unkyulee/bc250/images/001.jpeg

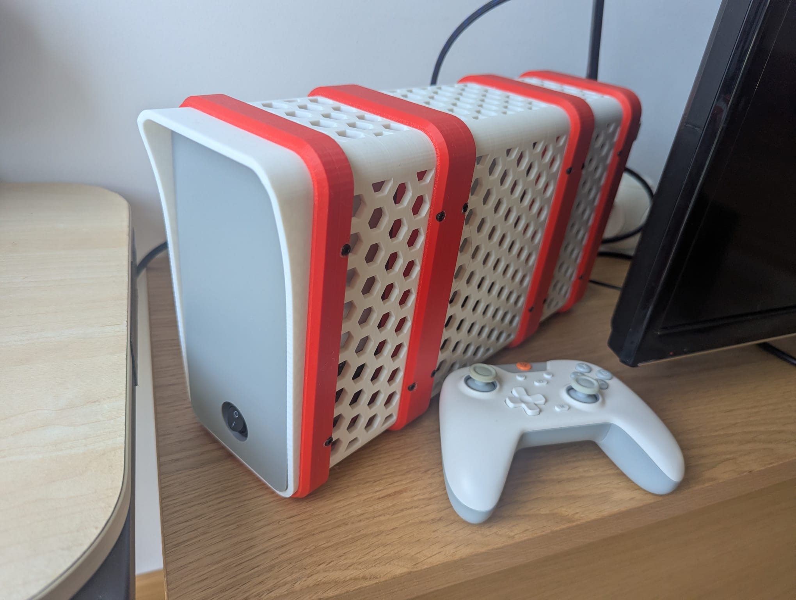
images/001.jpeg
