unkyulee/bc250/images/006.png

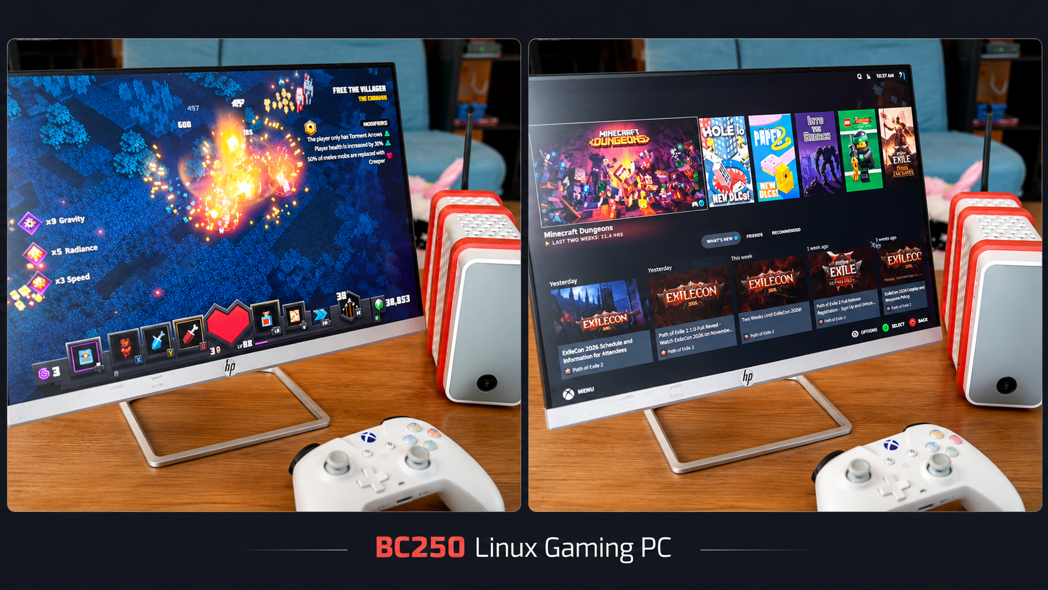
images/006.png
