unkyulee/bc250/STL/Fan Wall Front.stl

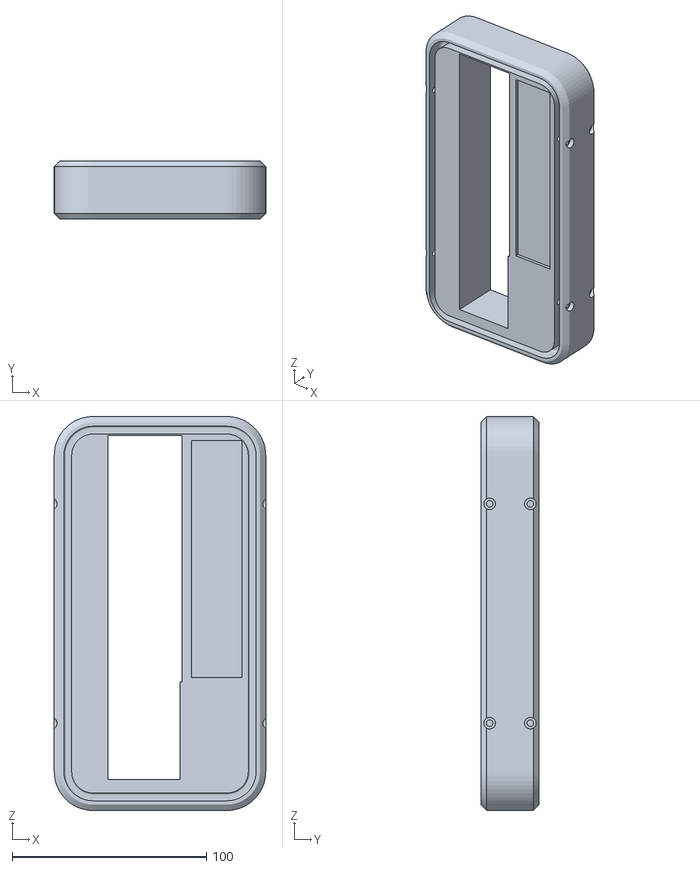
[picture p7: CAD file, 2026-10-29]
STL/Fan Wall Front.stl
109.0 x 30.0 x 203.0
