unkyulee/bc250/STL/Fan Wall Back.stl

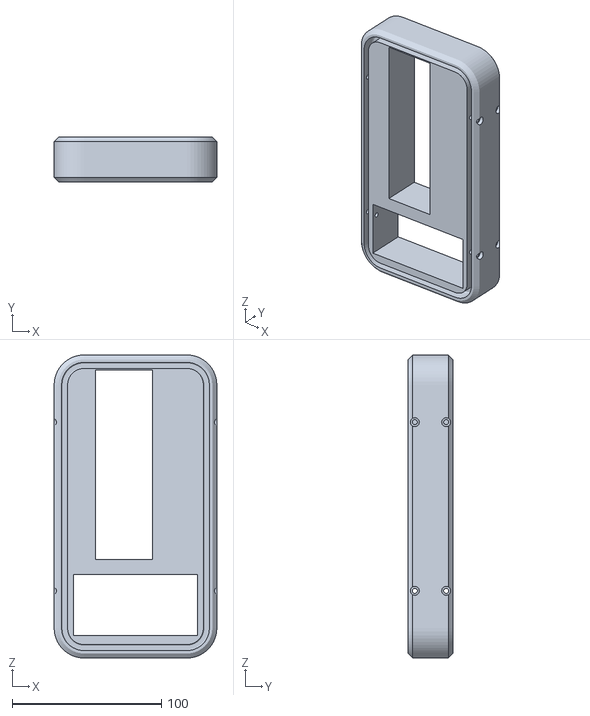
[picture p8: CAD file, 2026-10-29]
STL/Fan Wall Back.stl
109.0 x 30.0 x 203.0
