unkyulee/bc250/STL/p1s.3mf

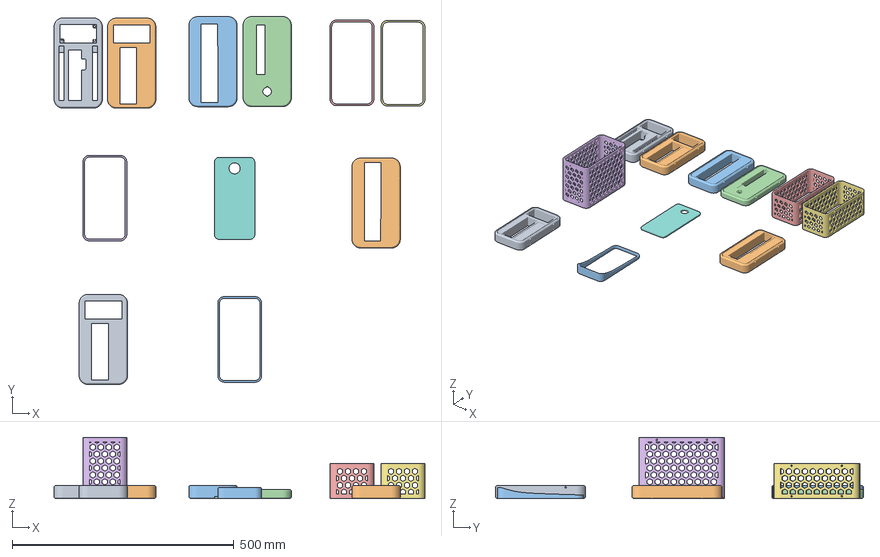
[picture p9: CAD file, 2026-10-29]
STL/p1s.3mf
835.3 x 828.9 x 138.0 mm
Back Face.stl
Fan Wall Back.stl x 2
Fan Wall Front.stl x 2
Front Face.stl
Cover Back.stl
Cover Fan.stl
Cover Front.stl
Front Panel.stl
Front Hood.stl
