unkyulee/bc250/STL/Back Face.stl

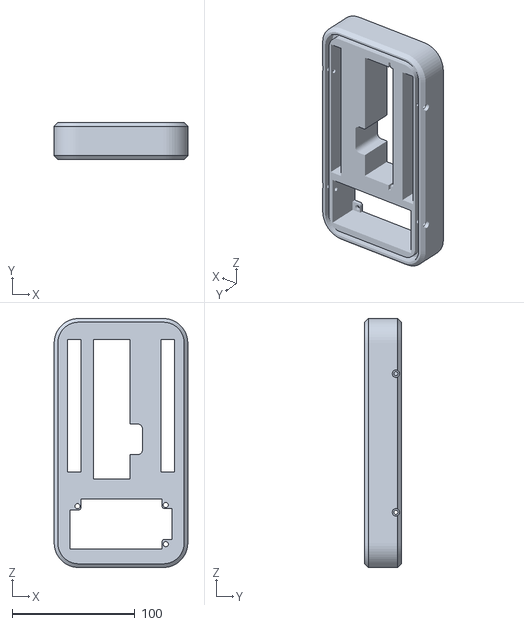
[picture p10: CAD file, 2026-09-11]
STL/Back Face.stl
109.0 x 30.0 x 203.0
