unkyulee/bc250/STL/Front Hood.stl

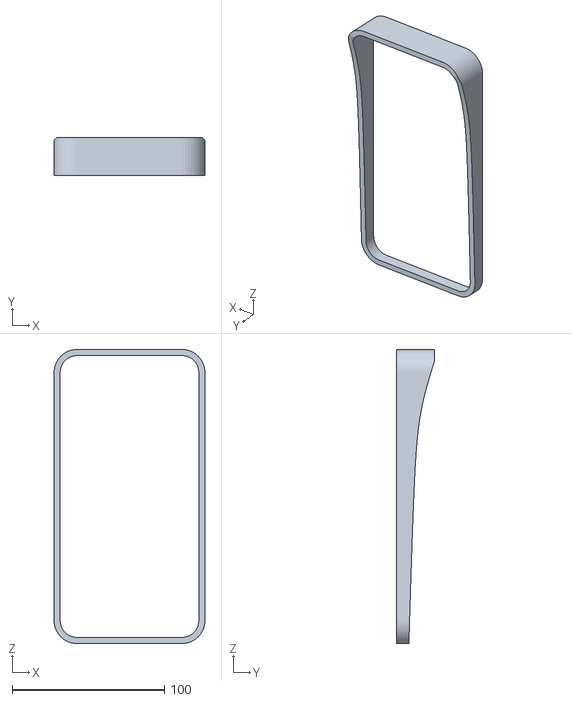
[picture p11: CAD file, 2026-09-11]
STL/Front Hood.stl
99.0 x 25.0 x 193.0
