unkyulee/bc250/STL/Cover Fan.stl

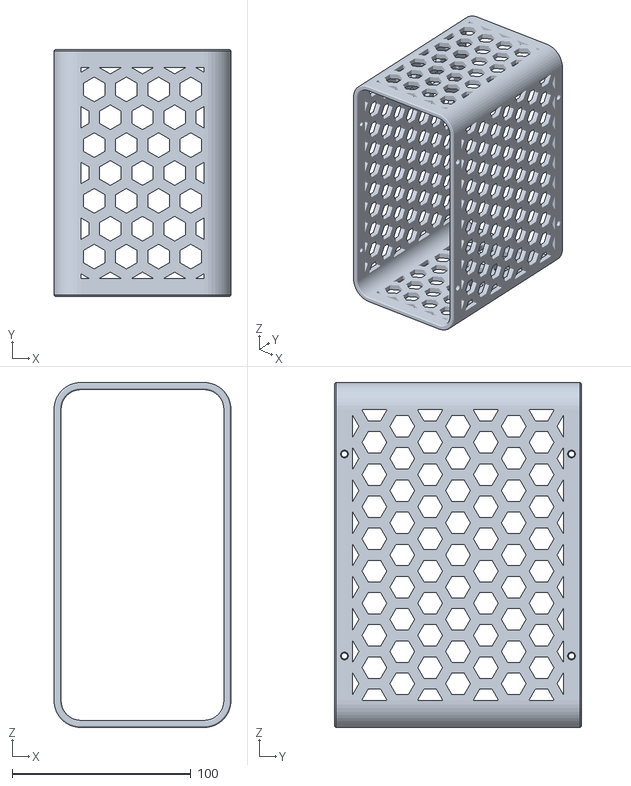
[picture p12: CAD file, 2026-09-11]
STL/Cover Fan.stl
99.0 x 138.0 x 193.0
