unkyulee/bc250/STL/Front Panel.stl

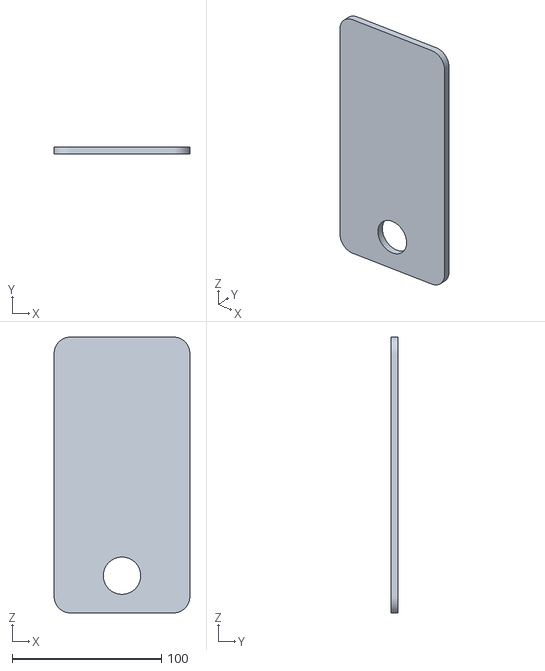
[picture p13: CAD file, 2026-09-11]
STL/Front Panel.stl
91.0 x 5.00 x 185.0
