unkyulee/bc250/STL/Cover Back.stl

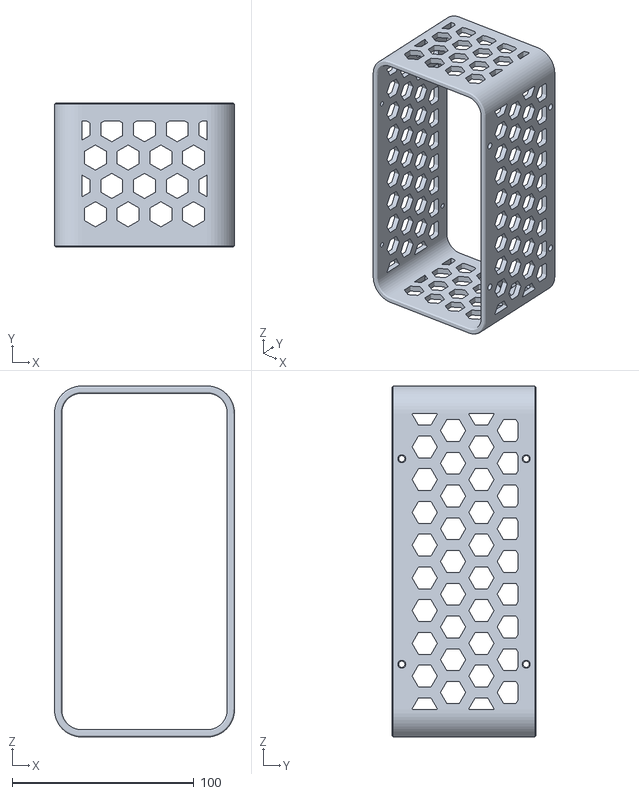
[picture p14: CAD file, 2026-09-11]
STL/Cover Back.stl
99.0 x 79.4 x 193.0
