unkyulee/bc250/STL/Front Face.stl

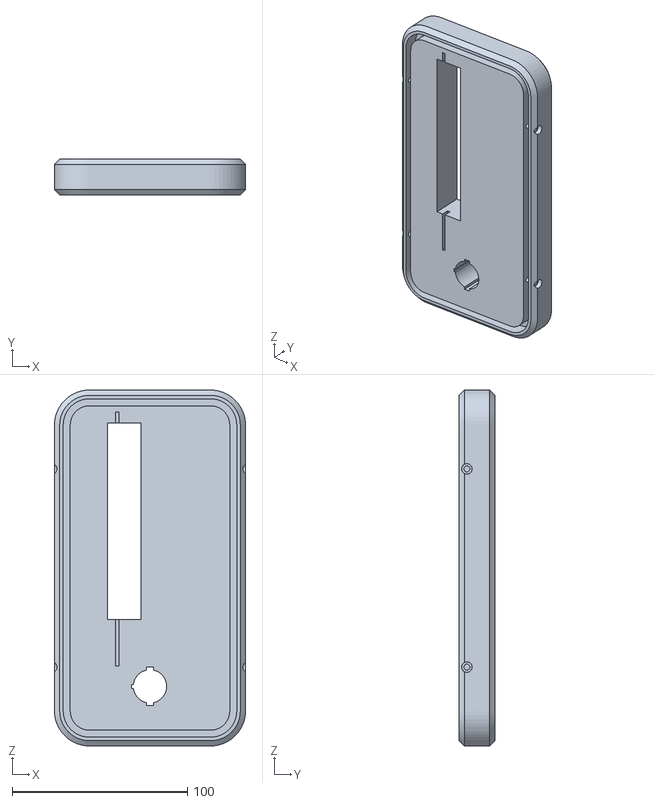
[picture p15: CAD file, 2026-09-11]
STL/Front Face.stl
109.0 x 20.5 x 203.0
