unkyulee/bc250/(list of files, cad)

Other CAD files:
STL/Cover Front.stl
STL/BC 250 Enclosure.f3d
