unkyulee/bc250/(commit log)

2026-09-11 draft design files
    [BC 250 Enclosure.f3d, Back Face.stl, Cover Back.stl, Cover Fan.stl, Cover Front.stl, Fan Wall Back.stl, Fan Wall Front.stl, Front Face.stl]
2026-10-29 bc250 build draft
    [BC 250 Enclosure.f3d, Fan Wall Back.stl, Fan Wall Front.stl, p1s.3mf]
